rayanquota/arduino-labview-ecg-monitor/docs/images/arduino-serial-sketch.png

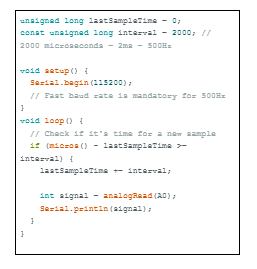
docs/images/arduino-serial-sketch.png
