rayanquota/arduino-labview-ecg-monitor/docs/images/design-calculations.jpg

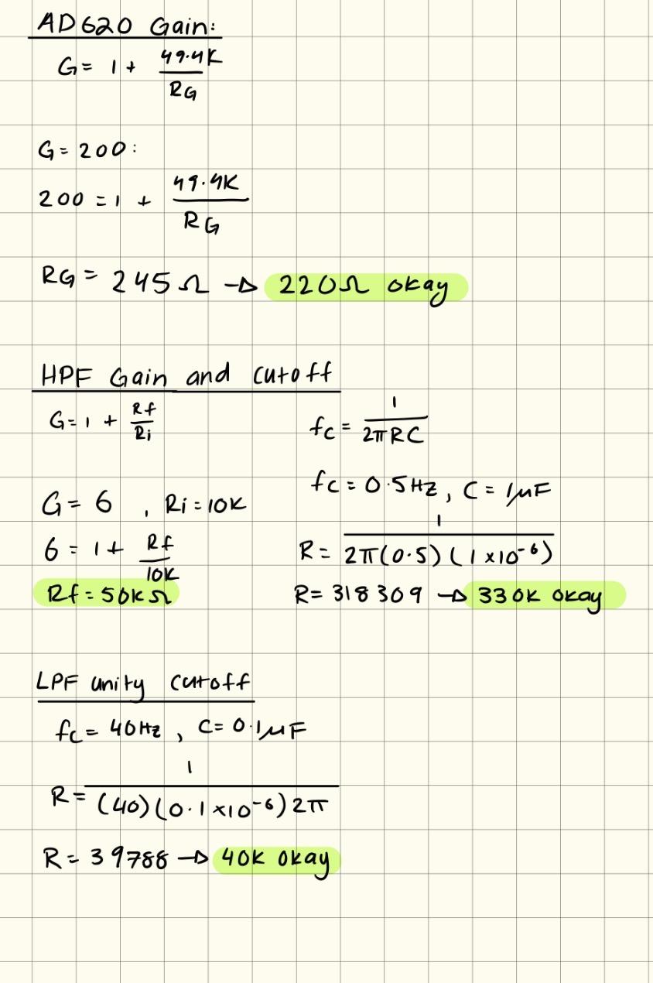
docs/images/design-calculations.jpg
